Gernreich/uilleann-chanter/step/uilleann-chanter-square-bore.step

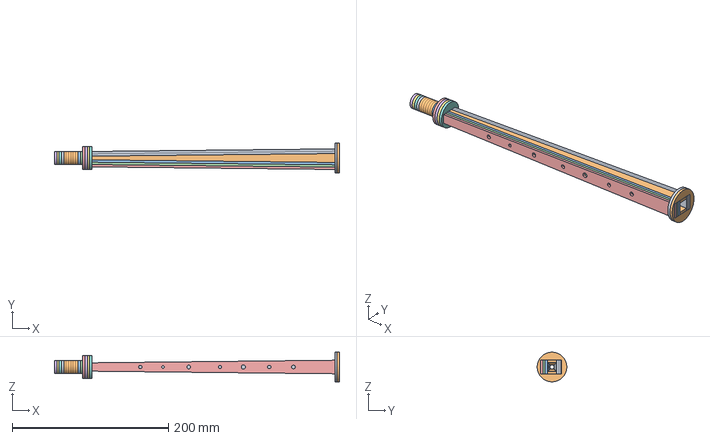
[picture p1: CAD file, 2026-11-08]
step/uilleann-chanter-square-bore.step
365.0 x 38.0 x 38.0 mm
