Gernreich/uilleann-chanter/(commit log)

2026-10-24 Uilleann chanter: Craig Fischer's square chanter in laser-cut strips
    A tapering square bore of butt-jointed ply strips (2-layer back, two sides,
    3-layer lid that comes off for tuning), Fischer's eight holes at his
    positions and drill sizes, his four bore dishes as greyscale engraves on
    the lid's bore layer, and a pinned tenon, collar, socket and foot. One
    587 x 166mm sheet; imports ../practice-chanters.
2026-11-07 Call lasermade-tools' Rust programs, not its Python scripts
    The tools became Rust on 2026-11-07: target/release/<name> in lasermade-tools
    (cargo build --release there) replaces python3 <name>.py, in commands,
    manifests and prose. Pages rebuilt; no generated file changes otherwise.
2026-11-07 3D page through lasermade-tools' turn3d program; turn3d.py is gone
    The page is byte for byte the same.
2026-11-07 uilleann_chanter.rs: the generator is Rust, the cut file and page byte for byte the same; --bores for bore-tmm
2026-11-08 Cargo.lock: four-hole-ocarinas now builds on square-flute
2026-11-08 Cargo.lock: bore-tmm now depends on lasermade-tools and roxmltree
2026-11-08 STEP files of the 3D view, for a CAD program
    One file per design in step/, one solid body per part, written from the
    3D page by lasermade-tools step-export and checked by .repro. Every file
    opens in SolidCraft with every body closed and no warnings.
    [uilleann-chanter-square-bore.step]
2026-11-08 Parametric SolidCraft design; the STEP built by SolidCraft
    uilleann_solidcraft.rs writes the chanter as a SolidCraft script
    (uilleann_chanter --solidcraft=DIR): Fischer's bore, the ply, the holes and
    the plates are parameters, each strip leaning with the cone, the first dish's
    lobe on the top plates' bores. Checked part by part: 25 parts within 0.04 mm,
    and the same at 2.9 mm ply with an 18 mm tenon.
    [uilleann-chanter-square-bore.step]
